Jelte-Boumans/Smart-Car/README.md

# Smart-Car
* Analyse bevat alle files die behoren tot de analyse van dit project
* Code bavat alle software geschreven voor dit project
* Schemas bevat alle versies van de schemas en PCBs voor dit project
