Jelte-Boumans/Smart-Car/Schemas/SmartCar V2/SmartCar ESP V2.brd

## EAGLE design Schemas/SmartCar V2/SmartCar ESP V2.brd (2022-05-04, an earlier design)

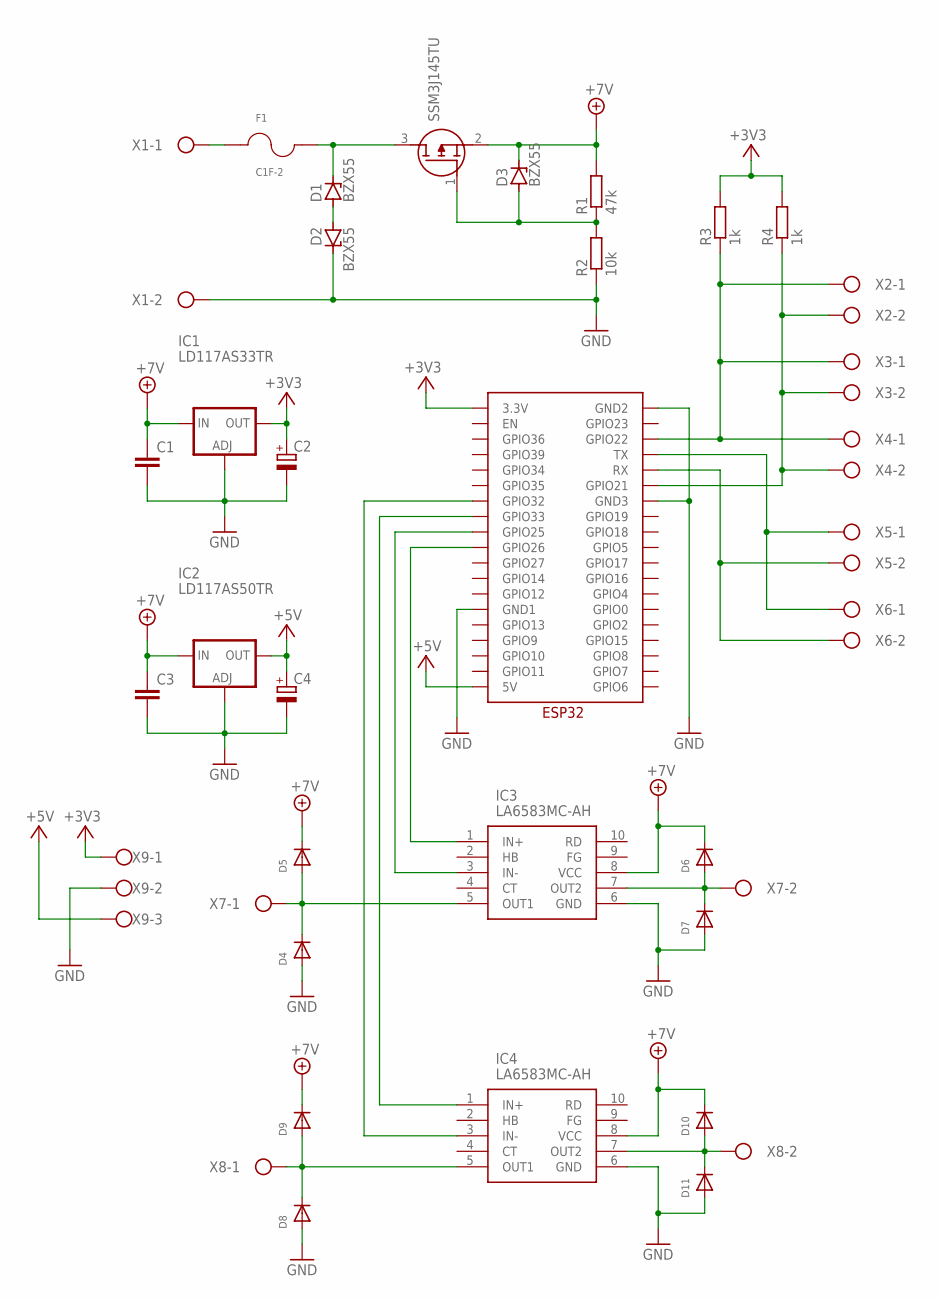
[picture p24: schematic SmartCar ESP V2.sch]

Parts:
C1, C3: C-EUC0805; C0805
C2, C4: CPOL-EUE2,5-6E; E2,5-6E
D1, D2, D3: BZX55; DO35Z10
D4, D5, D6, D7, D8, D9, D10, D11: DIODESMA; SMADIODE
F1: C1F-2; FUSC3215X83N
IC1: LD117AS33TR; SOT223
IC2: LD117AS50TR; SOT223
IC3, IC4: LA6583MC-AH; SOP100P620X155-10N
R1: 47k; R0805
R2: 10k; R0805
R3, R4: 1k; R0805
U$1: ESP32
U$2: SSM3J145TU; SOTFL65P210X75-3N
X1, X2, X3, X4, X5, X6, X7, X8: W237-102
X9: W237-103

Connections:
+3V3: C2.+, IC1.4 (OUT), R3.2, R4.2, U$1.3.3V, X9.1
+5V: C4.+, IC2.4 (OUT), U$1.5V, X9.3
+7V: C1.1, C3.1, D3.C, D5.C, D6.C, D9.C, D10.C, IC1.3 (IN), IC2.3 (IN), IC3.8 (VCC), IC4.8 (VCC), R1.2, U$2.2 (S)
GND: C1.2, C2.-, C3.2, C4.-, D2.C, D4.A, D7.A, D8.A, D11.A, IC1.1 (ADJ), IC2.1 (ADJ), IC3.6 (GND), IC4.6 (GND), R2.1, U$1.GND1, U$1.GND2, U$1.GND3, X1.2, X9.2
unnamed: F1.1, X1.1
unnamed: D1.A, D2.A
unnamed: D1.C, F1.2, U$2.3 (D)
unnamed: R4.1, U$1.GPIO21, X2.2, X3.2, X4.2
unnamed: U$1.TX, X5.1, X6.1
unnamed: D3.A, R1.1, R2.2, U$2.1 (G)
unnamed: R3.1, U$1.GPIO22, X2.1, X3.1, X4.1
unnamed: D4.C, D5.A, IC3.5 (OUT1), X7.1
unnamed: D6.A, D7.C, IC3.7 (OUT2), X7.2
unnamed: D10.A, D11.C, IC4.7 (OUT2), X8.2
unnamed: D8.C, D9.A, IC4.5 (OUT1), X8.1
unnamed: IC3.1 (IN+), U$1.GPIO26
unnamed: IC3.3 (IN-), U$1.GPIO25
unnamed: IC4.1 (IN+), U$1.GPIO33
unnamed: IC4.3 (IN-), U$1.GPIO32
unnamed: U$1.RX, X5.2, X6.2

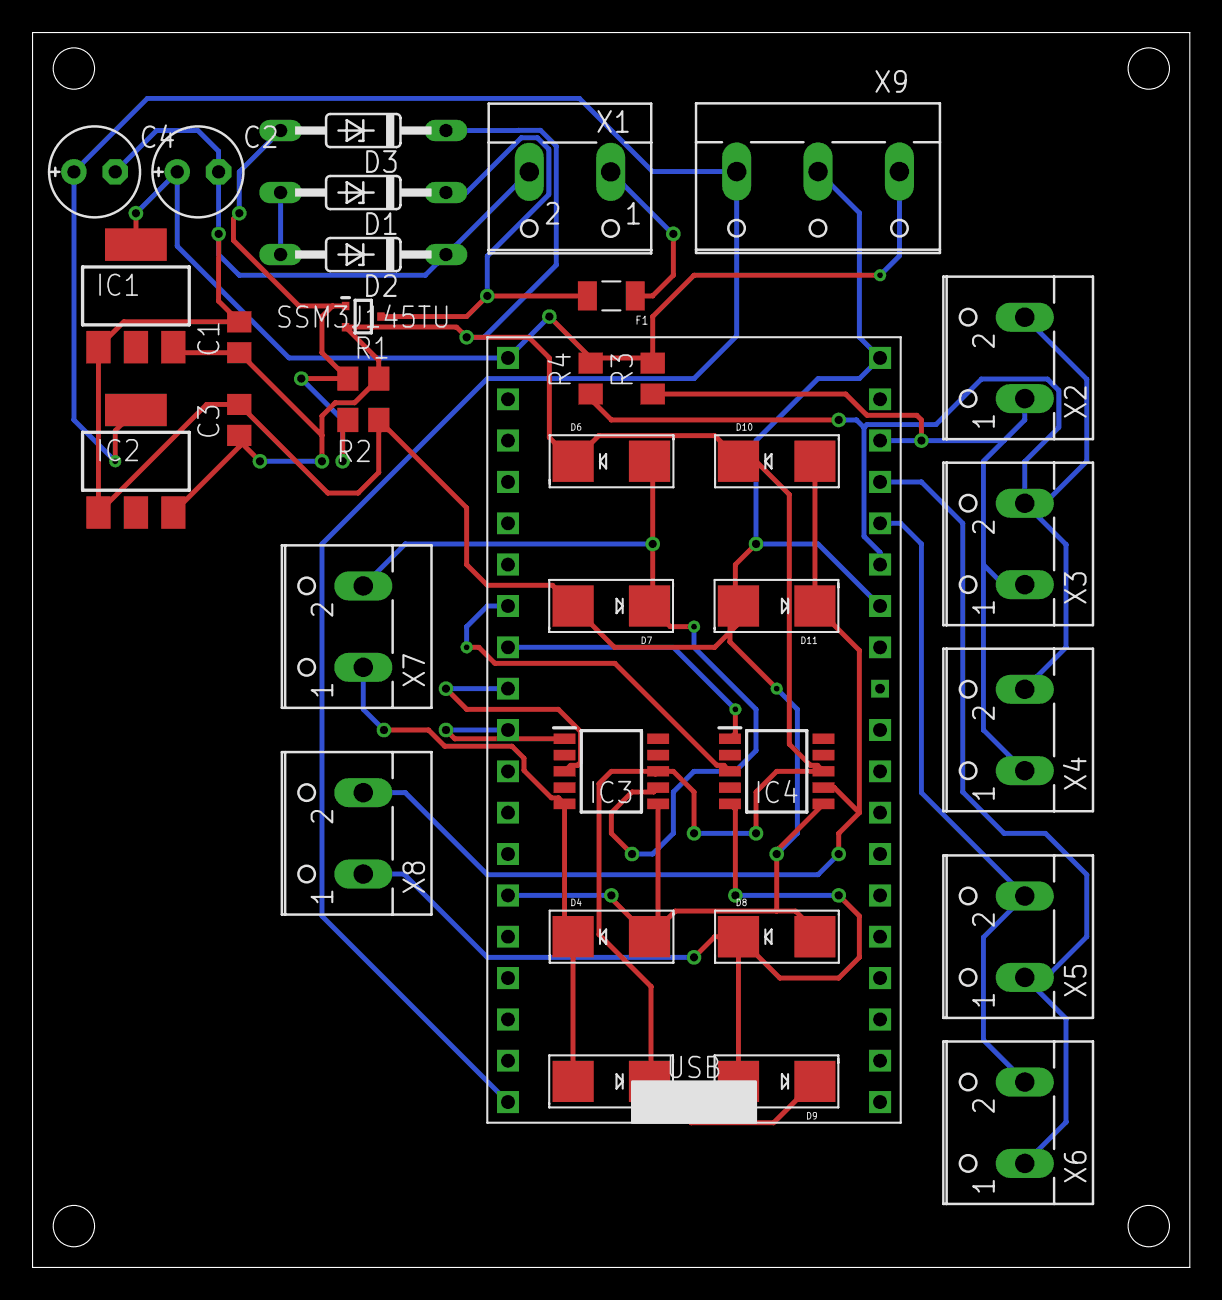
[picture p25: board SmartCar ESP V2.brd from above]

Board: 2 copper layers, 71.1 x 75.9 mm, 35 parts (0 on the bottom side), 20 nets.
