Jelte-Boumans/Smart-Car/Schemas/SmartCar V3/SmartCar ESP V3.brd

## EAGLE design Schemas/SmartCar V3/SmartCar ESP V3.brd (2022-05-04, an earlier design)

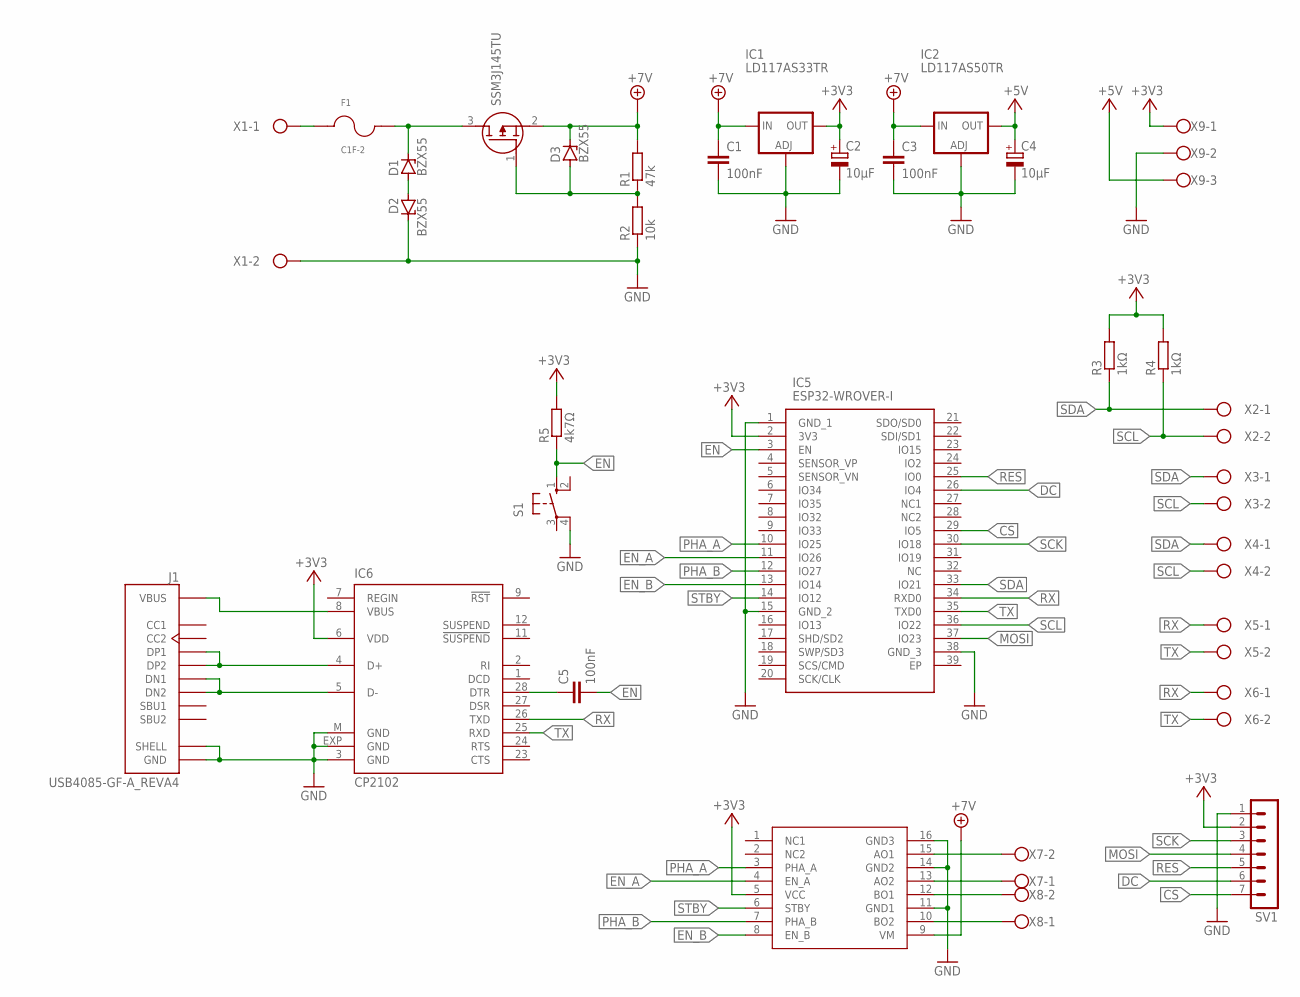
[picture p26: schematic SmartCar ESP V3.sch]

Parts:
C1, C3, C5: 100nF; C0805
C2, C4: 10µF; E2,5-6E
D1, D2, D3: BZX55; DO35Z10
F1: C1F-2; FUSC3215X83N
IC1: LD117AS33TR; SOT223
IC2: LD117AS50TR; SOT223
IC5: ESP32-WROVER-I; ESP32WROVERI
IC6: CP2102; MLP28
J1: USB4085-GF-A_REVA4; GCT_USB4085-GF-A_REVA4
R1: 47k; R0805
R2: 10k; R0805
R3, R4: 1kΩ; R0805
R5: 4k7Ω; R0805
S1: 10-XX; B3F-10XX
SV1: MA07-1
U$1: TC78H621FNG; SOP65P640X110-16N
U$2: SSM3J145TU; SOTFL65P210X75-3N
X1, X2, X3, X4, X5, X6, X7, X8: W237-102
X9: W237-103

Connections:
+3V3: C2.+, IC1.4 (OUT), IC5.2 (3V3), IC6.6 (VDD), R3.2, R4.2, R5.2, SV1.2, U$1.5 (VCC), X9.1
+5V: C4.+, IC2.4 (OUT), X9.3
+7V: C1.1, C3.1, D3.C, IC1.3 (IN), IC2.3 (IN), R1.2, U$1.9 (VM), U$2.2 (S)
CS: IC5.29 (IO5), SV1.7
DC: IC5.26 (IO4), SV1.6
EN: C5.2, IC5.3 (EN), R5.1, S1.1 (S)
EN_A: IC5.11 (IO26), U$1.4 (EN_A)
EN_B: IC5.13 (IO14), U$1.8 (EN_B)
GND: C1.2, C2.-, C3.2, C4.-, D2.C, IC1.1 (ADJ), IC2.1 (ADJ), IC5.1 (GND_1), IC5.15 (GND_2), IC5.38 (GND_3), IC6.3 (GND), IC6.EXP (GND), IC6.M (GND), J1.A1 (GND), J1.A12 (GND), J1.B1 (GND), J1.B12 (GND), J1.P1 (SHELL), J1.P2 (SHELL), J1.P3 (SHELL), J1.P4 (SHELL), R2.1, S1.4 (P1), SV1.1, U$1.11 (GND1), U$1.14 (GND2), U$1.16 (GND3), X1.2, X9.2
MOSI: IC5.37 (IO23), SV1.4
unnamed: F1.1, X1.1
unnamed: D1.A, D2.A
unnamed: D1.C, F1.2, U$2.3 (D)
unnamed: IC6.5 (D-), J1.A7 (DN1), J1.B7 (DN2)
unnamed: IC6.4 (D+), J1.A6 (DP1), J1.B6 (DP2)
unnamed: C5.1, IC6.28 (DTR)
unnamed: D3.A, R1.1, R2.2, U$2.1 (G)
unnamed: U$1.15 (AO1), X7.2
unnamed: U$1.13 (AO2), X7.1
unnamed: U$1.12 (BO1), X8.2
unnamed: U$1.10 (BO2), X8.1
unnamed: IC6.8 (VBUS), J1.A4 (VBUS), J1.A9 (VBUS), J1.B4 (VBUS), J1.B9 (VBUS)
PHA_A: IC5.10 (IO25), U$1.3 (PHA_A)
PHA_B: IC5.12 (IO27), U$1.7 (PHA_B)
RES: IC5.25 (IO0), SV1.5
RX: IC5.34 (RXD0), IC6.26 (TXD), X5.1, X6.1
SCK: IC5.30 (IO18), SV1.3
SCL: IC5.36 (IO22), R4.1, X2.2, X3.2, X4.2
SDA: IC5.33 (IO21), R3.1, X2.1, X3.1, X4.1
STBY: IC5.14 (IO12), U$1.6 (STBY)
TX: IC5.35 (TXD0), IC6.25 (RXD), X5.2, X6.2

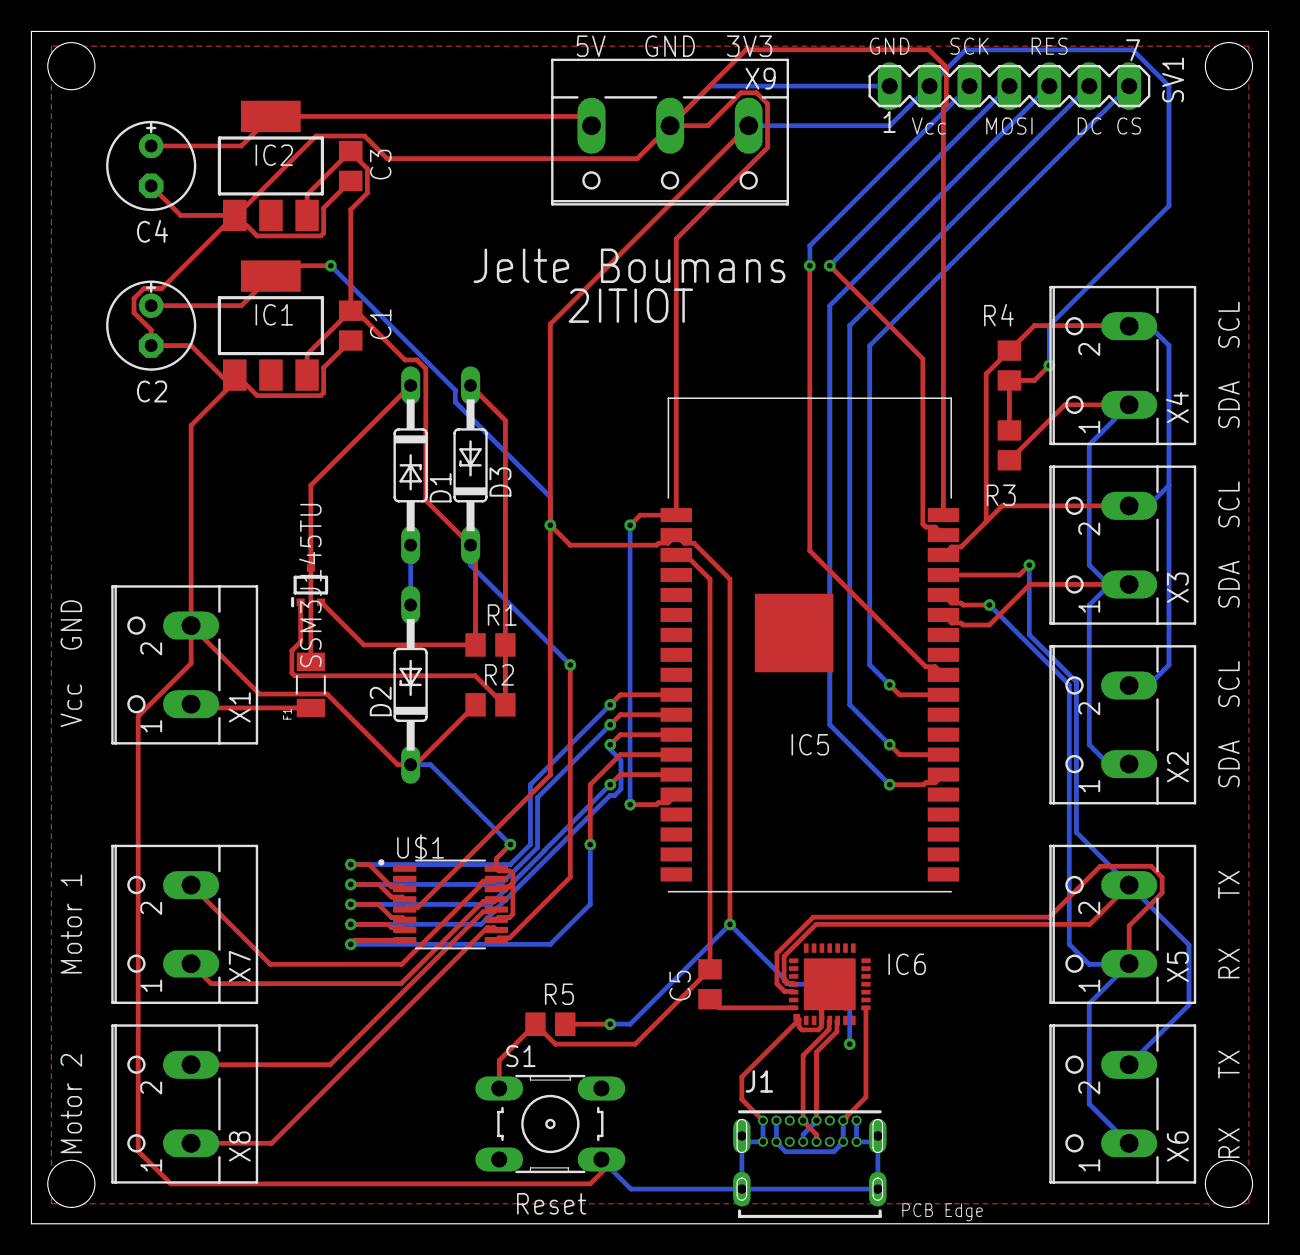
[picture p27: board SmartCar ESP V3.brd from above]

Board: 2 copper layers, 78.7 x 75.9 mm, 32 parts (0 on the bottom side), 31 nets.
