Jelte-Boumans/Smart-Car/Schemas/SmartCar V4/SmartCar Arduino V4.brd

## EAGLE design Schemas/SmartCar V4/SmartCar Arduino V4.brd (2022-05-04)

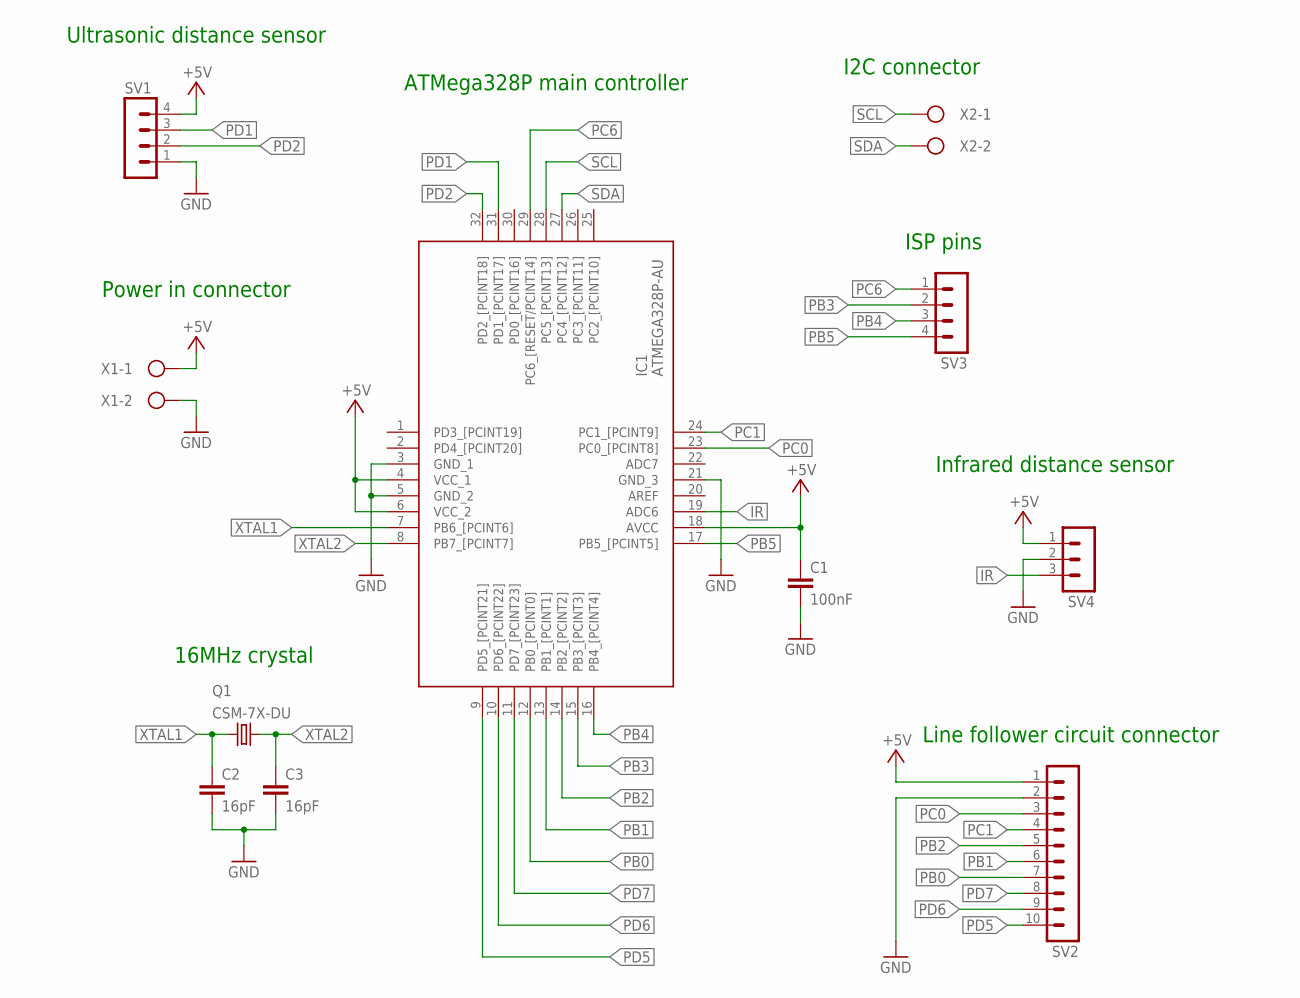
[picture p28: schematic SmartCar Arduino V4.sch]

Parts:
C1: 100nF; C0805
C2, C3: 16pF; C0805
IC1: ATMEGA328P-AU; QFP80P900X900X120-32N
Q1: CSM-7X-DU
SV1, SV3: 0; MA04-1
SV2: 0; MA10-1
SV4: 0; MA03-1
X1, X2: 0; W237-102

Connections:
+5V: C1.1, IC1.4 (VCC_1), IC1.6 (VCC_2), IC1.18 (AVCC), SV1.4, SV2.1, SV4.1, X1.1
GND: C1.2, C2.2, C3.2, IC1.3 (GND_1), IC1.5 (GND_2), IC1.21 (GND_3), SV1.1, SV2.2, SV4.2, X1.2
IR: IC1.19 (ADC6), SV4.3
PB0: IC1.12 (PB0_[PCINT0]), SV2.7
PB1: IC1.13 (PB1_[PCINT1]), SV2.6
PB2: IC1.14 (PB2_[PCINT2]), SV2.5
PB3: IC1.15 (PB3_[PCINT3]), SV3.2
PB4: IC1.16 (PB4_[PCINT4]), SV3.3
PB5: IC1.17 (PB5_[PCINT5]), SV3.4
PC0: IC1.23 (PC0_[PCINT8]), SV2.3
PC1: IC1.24 (PC1_[PCINT9]), SV2.4
PC6: IC1.29 (PC6_[RESET/PCINT14]), SV3.1
PD1: IC1.31 (PD1_[PCINT17]), SV1.3
PD2: IC1.32 (PD2_[PCINT18]), SV1.2
PD5: IC1.9 (PD5_[PCINT21]), SV2.10
PD6: IC1.10 (PD6_[PCINT22]), SV2.9
PD7: IC1.11 (PD7_[PCINT23]), SV2.8
SCL: IC1.28 (PC5_[PCINT13]), X2.1
SDA: IC1.27 (PC4_[PCINT12]), X2.2
XTAL1: C2.1, IC1.7 (PB6_[PCINT6]), Q1.1
XTAL2: C3.1, IC1.8 (PB7_[PCINT7]), Q1.2

Notes on the sheet:
Ultrasonic distance sensor
Power in connector
16MHz crystal
ATMega328P main controller
I2C connector
ISP pins
Infrared distance sensor
Line follower circuit connector

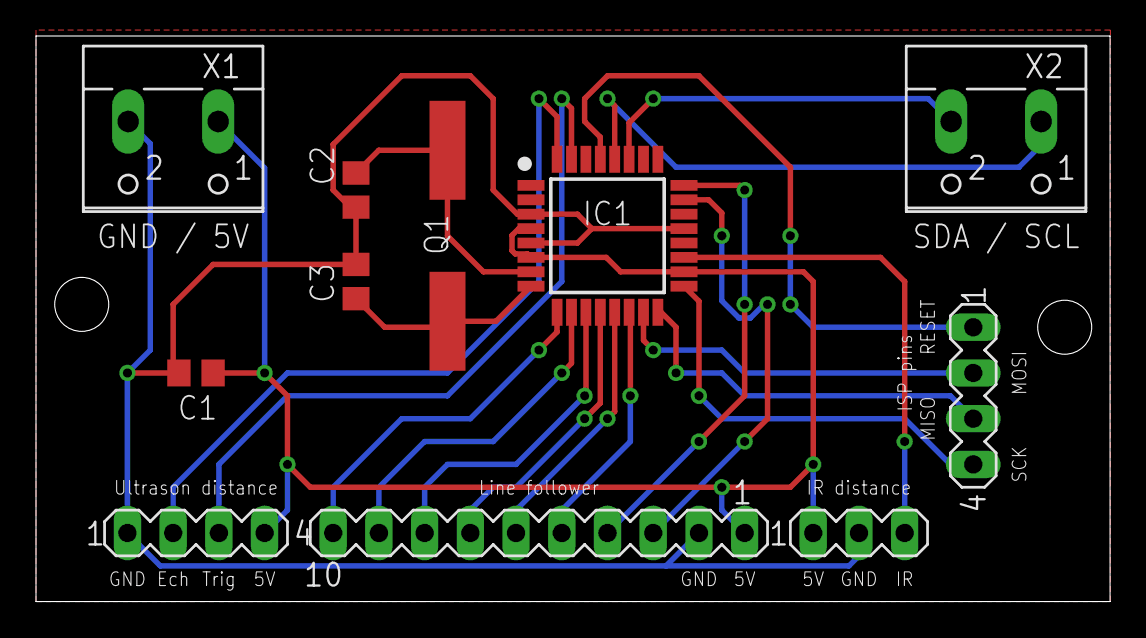
[picture p29: board SmartCar Arduino V4.brd from above]

Board: 2 copper layers, 59.7 x 31.4 mm, 11 parts (0 on the bottom side), 21 nets.
